Naoto8734/gripper-robo-BluePill/README.md

# gripper-robo-BluePill
STM32F103(BluePill)用の、CubeIDEのワークスペース。
回路図は以下の通り。(**未修正なので、現物と異なる**)

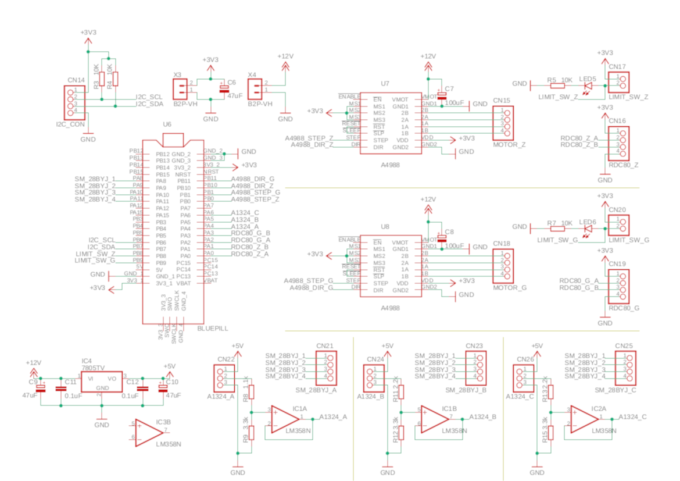
[picture p1: gripper-robo-controller-board.png]
circuit-board


LED_R(回路図に未記入)は、ピンがHIGHで点灯。
BluePill組み込みのLEDとは逆なので注意。
SW_BとSW_Wは、プルアップするので常時HIGH。押したときだけLOW。
マイコンのピン配置は次の通り。

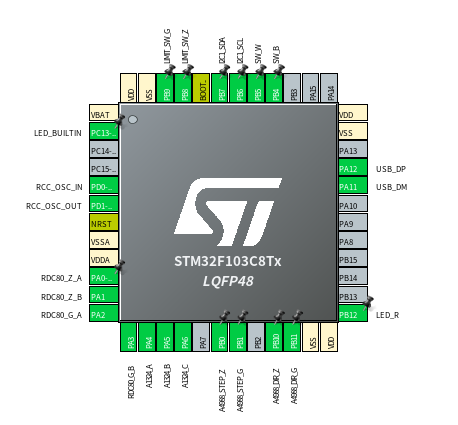
[picture p2: gripper-robo-pinmap.png]
pinmap


### グリッパーロボ用のリポジトリ一覧

- [ロボのグリッパー部のリポジトリ(これ)](https://github.com/Naoto8734/gripper-robo-BluePill)
- [ロボのXY直動部のリポジトリ](https://github.com/Naoto8734/xy-axis-robo-BluePill)
- [ロボの指先部のリポジトリ](https://github.com/Naoto8734/fingertip-robo-BluePill)

## 書き込み方法
OSはUbuntu。[J-Link EDU](https://www.embitek.co.jp/product/jlink-edu.html)を使用し、STM32CubeIDEで生成したbinファイルを書き込み。
**BluePill側の電源(3.3v)を入れておくこと。**
参考：[J-LinkでコマンドラインからマイコンのFlashに書き込む](http://idken.net/posts/2019-07-14-jlinkflash/)

### BluePillとJ-Link EDUとのピン接続

| SWD(JLink) | Pin# | | BluePill |
| ---- | ---- | ---- | ---- |
| VTref | 1 | |3V3(SWD-Connector) |
| GND | 4 | | GND(SWD-Connector) |
| SWDIO | 7 | | DIO(SWD-Connector) |
| SWCLK | 9 | | DCLK(SWD-Connector) |
| RESET | 15 | | R |

## ステッピングモータドライバA4988
- [ステッピングモータードライバA4988 - スイッチサイエンス](https://www.switch-science.com/catalog/582/)
 - 回路で、MS1,MS2,MS3はHIGHに固定しているので、1/16ステップ駆動
- 駆動するモータ：[Nema 17 Bipolar 59Ncm (84oz.in) 2A 42x48mm 4 Wires w/ 1m Cable & Connector](https://www.omc-stepperonline.com/nema-17-bipolar-59ncm-84oz-in-2a-42x48mm-4-wires-w-1m-cable-and-connector.html)
 - ステップアングルは、1.8[deg] = 360/200[deg]。
- よって、200*16=3200パルスをA4988に送るとステッピングモータは1回転。
- Z軸は1/2減速した後、ピッチ2mmの台形ネジによって移動する。
 - [304 ステンレス鋼 T12 台形スピンドルネジとナット - AliExpress](https://ja.aliexpress.com/item/32904305986.html)
 - つまり、ステッピングモータ1回転で1mm進む。
- グリッパは関節に1/20減速している。
 - つまり、関節角度は1/20すれば算出できる。
 
## 無限回転ポテンショメータRDC80
- [RDC80シリーズ｜RDC803101A｜基本情報](https://tech.alpsalpine.com/prod/j/html/sensor/position/rdc80/rdc803101a.html)
- 2T出力と4T出力が180度位相のずれたポテンショメータ。
- 基準勾配は100[%]/340[deg]なので、12[bit]でAD変換した時、角度分解能は340/4096=~0.083[deg]
- この基準勾配のうち、上限と下限の約3[%]/5[deg]は使用禁止領域。
 - よって使用可能範囲は、5[deg]~335[deg]。12[bit]の場合、60~4036。

## I2C Slave
- Slaveのアドレスを、`0x18`とする。(最終bitはR/Wなので、`0x0C`が7bitのアドレス)
- レジスタアドレス：`0x75` (WHO_AM_I)
 - 自身のSlaveアドレス`0x18`を返す
 
## C++に対応させる方法
参考：[How to Use C++ with STM32CubeIDE - Shawn Hymel](https://shawnhymel.com/1941/how-to-use-c-with-stm32cubeide/)

1. `main.c`を`main.cpp`に名前を変更。
2. `Project Explorer`の画面で、該当のプロジェクトを右クリック。`Convert C++`を選択。
3. Build (これで終了。HALの関数の引数がいくつか変更されるので、Errorに注意。)

### CubeMXで設定を変更した場合の対処法
`main.cpp`に変更しても、CubeMXで生成されるのは`main.c`のままとなる。
そこで、`main.cpp`を`main.c`に改名し、CubeMXからコードを生成する。
これにより、UserCodeの部分がそのまま引き継がれるので、再度`main.cpp`に変更し直す。
面倒くさい。

### 自作クラスの追加方法
1. `Project Explorer`の画面で、該当のプロジェクトを右クリック。`New -> (C++) Class`を選択。
2. Class Name`の欄に、適当な名前を入力して、Finish。
3. Coreフォルダに`***.h`と`***.cpp`ができるので、それぞれIncとSrcフォルダに突っ込む。
4. 作られた`***.h`ファイルで`#include "main.h"`する。
5. `main.cpp`ファイルで`#include "DriveMotor.h"`する。

クラスなどの命名規則：[ja/CppStyleGuide - ROS Wiki](http://wiki.ros.org/ja/CppStyleGuide)
