Naoto8734/gripper-robo-BluePill/Core/Src/main.c

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
/* Includes ------------------------------------------------------------------*/
#include "main.h"
#include "usb_device.h"

/* USER CODE BEGIN PTD */
typedef struct __potentio_rdc80 {
	double degree;
	int32_t half_rotation; //正方向に180degごとに1加算。
	double initial_degree;
	uint16_t phase_a;
	uint16_t phase_b;
} potentio_rdc80;

/* USER CODE END PTD */

/* USER CODE BEGIN PD */
//セッティング用定数
//グリッパーの目標角度[deg]
#define TARGET_GRIPPER_DEG 30.0
//z軸の目標下げ変位[mm]
#define TARGET_Z_DISP 86.0


//ADC
#define ADC_ARR_SIZE 7
#define ADC_12BIT_MAX 4095
//RDC80
#define ADC_RDC80_DEG_CONST 0.0830 //12bitのADC値から、角度に変換するための定数。
#define ADC_RDC80_MIN 1023-10 //この値未満になった時に、計測する相を切り替える。
#define ADC_RDC80_MAX 3071+10 //この値より上になった時に、計測する相を切り替える。
#define ADC_INIT_VAL_RDC80_ZA 3492
#define ADC_INIT_VAL_RDC80_ZB 1329 //こちらが最初に計測する相
#define ADC_INIT_DEG_Z -29.84131 +180.0 //初期角度(ADの実測値からの計算)
#define ADC_INIT_VAL_RDC80_GA 164
#define ADC_INIT_VAL_RDC80_GB 2152 //こちらが最初に計測する相
#define ADC_INIT_DEG_G 8.63281 - 180.0//初期角度(ADの実測値からの計算)
//(本当は-172degだが、phaseの初期値を-1するためこの角度)
/* USER CODE END PD */

ADC_HandleTypeDef hadc1;
DMA_HandleTypeDef hdma_adc1;

I2C_HandleTypeDef hi2c1;

TIM_HandleTypeDef htim3;

/* USER CODE BEGIN PV */
__IO uint16_t adc_vals[ADC_ARR_SIZE];
potentio_rdc80 prdZ, prdG;
/* USER CODE END PV */

void SystemClock_Config(void);
static void MX_GPIO_Init(void);
static void MX_DMA_Init(void);
static void MX_ADC1_Init(void);
static void MX_I2C1_Init(void);
static void MX_TIM3_Init(void);
/* USER CODE BEGIN PFP */
//void adc2deg_rdc80(potentio_rdc80 *);
void adc2deg_rdc80Z(void);
void driveZ(double);
void adc2deg_rdc80G(void);
void driveG(double);
/* USER CODE END PFP */

/**
  * @brief  The application entry point.
  * @retval int
  */
int main(void)
{
  /* MCU Configuration--------------------------------------------------------*/

  /* Reset of all peripherals, Initializes the Flash interface and the Systick. */
  HAL_Init();

  /* Configure the system clock */
  SystemClock_Config();

  /* Initialize all configured peripherals */
  MX_GPIO_Init();
  MX_DMA_Init();
  MX_ADC1_Init();
  MX_I2C1_Init();
  MX_TIM3_Init();
  MX_USB_DEVICE_Init();
  /* USER CODE BEGIN 2 */
	//タイマー割り込みの開始
	HAL_TIM_Base_Start_IT(&htim3);

	// Potentio RDc80 initialize
	prdZ.initial_degree = ADC_INIT_DEG_Z;
	prdZ.half_rotation = 1;//ADC_INIT_DEGの値により変える。
	prdG.initial_degree = ADC_INIT_DEG_G;
	prdG.half_rotation = -1;

	//ADCのDMA転送開始
	HAL_ADC_Start_DMA(&hadc1,(uint32_t *)adc_vals, ADC_ARR_SIZE);


  /* USER CODE END 2 */

  /* Infinite loop */
  /* USER CODE BEGIN WHILE */

	//Initialize A4988 pin
	//正の方向 : deg+ : グリッパ閉じる。
	HAL_GPIO_WritePin(A4988_DIR_G_GPIO_Port, A4988_DIR_G_Pin, GPIO_PIN_RESET);
	//正の方向 : deg+ : 下に下がる。
	HAL_GPIO_WritePin(A4988_DIR_Z_GPIO_Port, A4988_DIR_Z_Pin, GPIO_PIN_RESET);

	//Enable Motor PWM
	HAL_TIM_PWM_Start(&htim3, TIM_CHANNEL_3);
	HAL_TIM_PWM_Start(&htim3, TIM_CHANNEL_4);

	HAL_GPIO_WritePin(LED_R_GPIO_Port, LED_R_Pin, GPIO_PIN_SET);

	while (1) {
		//ボタン入力待機
		while(HAL_GPIO_ReadPin(SW_B_GPIO_Port, SW_B_Pin) != GPIO_PIN_RESET){
			HAL_GPIO_TogglePin(LED_R_GPIO_Port, LED_R_Pin);
			HAL_Delay(200);
		}
		HAL_GPIO_WritePin(LED_R_GPIO_Port, LED_R_Pin, GPIO_PIN_RESET);

		//Z軸下げる
		HAL_GPIO_WritePin(LED_BUILTIN_GPIO_Port, LED_BUILTIN_Pin, GPIO_PIN_RESET);
		driveZ(360.0*TARGET_Z_DISP);
		HAL_GPIO_WritePin(LED_BUILTIN_GPIO_Port, LED_BUILTIN_Pin, GPIO_PIN_SET);

		//ボタン入力待機
		while(HAL_GPIO_ReadPin(SW_B_GPIO_Port, SW_B_Pin) != GPIO_PIN_RESET){
			HAL_GPIO_TogglePin(LED_R_GPIO_Port, LED_R_Pin);
			HAL_Delay(200);
		}
		HAL_GPIO_WritePin(LED_R_GPIO_Port, LED_R_Pin, GPIO_PIN_RESET);

		//G軸閉じる
		HAL_GPIO_WritePin(LED_BUILTIN_GPIO_Port, LED_BUILTIN_Pin, GPIO_PIN_RESET);
		driveG(TARGET_GRIPPER_DEG*20.0);
		HAL_GPIO_WritePin(LED_BUILTIN_GPIO_Port, LED_BUILTIN_Pin, GPIO_PIN_SET);
		HAL_Delay(2000);

		//ボタン入力待機
		while(HAL_GPIO_ReadPin(SW_B_GPIO_Port, SW_B_Pin) != GPIO_PIN_RESET){
			HAL_GPIO_TogglePin(LED_R_GPIO_Port, LED_R_Pin);
			HAL_Delay(200);
		}
		HAL_GPIO_WritePin(LED_R_GPIO_Port, LED_R_Pin, GPIO_PIN_RESET);

		//Z軸戻す
		HAL_GPIO_WritePin(LED_BUILTIN_GPIO_Port, LED_BUILTIN_Pin, GPIO_PIN_RESET);
		driveZ(0.0);
		HAL_GPIO_WritePin(LED_BUILTIN_GPIO_Port, LED_BUILTIN_Pin, GPIO_PIN_SET);
		HAL_Delay(2000);

		//ボタン入力待機
		while(HAL_GPIO_ReadPin(SW_B_GPIO_Port, SW_B_Pin) != GPIO_PIN_RESET){
			HAL_GPIO_TogglePin(LED_R_GPIO_Port, LED_R_Pin);
			HAL_Delay(200);
		}
		HAL_GPIO_WritePin(LED_R_GPIO_Port, LED_R_Pin, GPIO_PIN_RESET);

		//G軸戻す
		HAL_GPIO_WritePin(LED_BUILTIN_GPIO_Port, LED_BUILTIN_Pin, GPIO_PIN_RESET);
		driveG(0.0);
		HAL_GPIO_WritePin(LED_BUILTIN_GPIO_Port, LED_BUILTIN_Pin, GPIO_PIN_SET);
		HAL_Delay(2000);
    /* USER CODE END WHILE */

    /* USER CODE BEGIN 3 */
	}
  /* USER CODE END 3 */
}

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
/* USER CODE BEGIN 4 */
void HAL_GPIO_EXTI_Callback(uint16_t GPIO_Pin) {
	//Todo:リミットスイッチ用の割り込み
	if (GPIO_Pin == LIMIT_SW_G_Pin) {
	}
	if (GPIO_Pin == LIMIT_SW_Z_Pin) {
	}
}

//下に下げると負の値になる。
void adc2deg_rdc80Z(void){
	if(((prdZ.half_rotation) %2) == 0){
		//a相が計測範囲内
		prdZ.degree = (double) ((prdZ.phase_a * ADC_RDC80_DEG_CONST) - 170.0);
		if(prdZ.phase_a < 683){
			//計測範囲を下回ったので、b相で計測する。
			prdZ.degree = (double) ((prdZ.phase_b * ADC_RDC80_DEG_CONST) - 170.0);
			prdZ.half_rotation--;
		}else if (prdZ.phase_a > 3413){
			//計測範囲を上回ったので、b相で計測する。
			prdZ.degree = (double) ((prdZ.phase_b * ADC_RDC80_DEG_CONST) - 170.0);
			prdZ.half_rotation++;
		}
	}else{
		//b相が計測範囲内
		prdZ.degree = (double) ((prdZ.phase_b * ADC_RDC80_DEG_CONST) - 170.0);
		if(prdZ.phase_b < 683){
			//計測範囲を下回ったので、a相で再計測する。
			prdZ.degree = (double) ((prdZ.phase_a * ADC_RDC80_DEG_CONST) - 170.0);
			prdZ.half_rotation--;
		}else if(prdZ.phase_b > 3413){
			//計測範囲を超えたので、a相で再計測する。
			prdZ.degree = (double) ((prdZ.phase_a * ADC_RDC80_DEG_CONST) - 170.0);
			prdZ.half_rotation++;
		}
	}
	prdZ.degree += (double) ((prdZ.half_rotation) * 180.0);
	prdZ.degree -= prdZ.initial_degree;
}

void adc2deg_rdc80G(void){
	if(((prdG.half_rotation) %2) == 0){
		//a相が計測範囲内
		prdG.degree = (double) ((prdG.phase_a * ADC_RDC80_DEG_CONST) - 170.0);
		if(prdG.phase_a < 683){
			//計測範囲を下回ったので、b相で計測する。
			prdG.degree = (double) ((prdG.phase_b * ADC_RDC80_DEG_CONST) - 170.0);
			prdG.half_rotation--;
		}else if (prdG.phase_a > 3413){
			//計測範囲を上回ったので、b相で計測する。
			prdG.degree = (double) ((prdG.phase_b * ADC_RDC80_DEG_CONST) - 170.0);
			prdG.half_rotation++;
		}
	}else{
		//b相が計測範囲内
		prdG.degree = (double) ((prdG.phase_b * ADC_RDC80_DEG_CONST) - 170.0);
		if(prdG.phase_b < 683){
			//計測範囲を下回ったので、a相で再計測する。
			prdG.degree = (double) ((prdG.phase_a * ADC_RDC80_DEG_CONST) - 170.0);
			prdG.half_rotation--;
		}else if(prdG.phase_b > 3413){
			//計測範囲を超えたので、a相で再計測する。
			prdG.degree = (double) ((prdG.phase_a * ADC_RDC80_DEG_CONST) - 170.0);
			prdG.half_rotation++;
		}
	}
	prdG.degree += (double) ((prdG.half_rotation) * 180.0);
	prdG.degree -= prdG.initial_degree;
}

void HAL_ADC_ConvCpltCallback(ADC_HandleTypeDef *hadc) {
	prdZ.phase_a = adc_vals[0];
	prdZ.phase_b = adc_vals[1];
	prdG.phase_a = adc_vals[2];
	prdG.phase_b = adc_vals[3];
}

//Z軸モータを指定の角度に駆動する関数。
//プラスを指定すると、下に動く。
void driveZ(double command_deg){
	uint8_t degOK = 0;
	double tmpDeg = 0.0;
	while (!degOK){
		adc2deg_rdc80Z();
		tmpDeg = command_deg + prdZ.degree;
		//adc2deg_rdc80Zは下方向へ動かすとマイナス。しかし、入力は下をプラスにしたいのでこうした。
		if(tmpDeg>=3.0){
			if(tmpDeg>=120.0)__HAL_TIM_SET_PRESCALER(&htim3,72-1);//Change motor speed
			else __HAL_TIM_SET_PRESCALER(&htim3,1152-1);//Change motor speed
			HAL_GPIO_WritePin(A4988_DIR_Z_GPIO_Port, A4988_DIR_Z_Pin, GPIO_PIN_RESET);
			__HAL_TIM_SET_COMPARE(&htim3, TIM_CHANNEL_3, 50);//Motor Z
		}else if (tmpDeg<= -3.0){
			if(tmpDeg<=-120.0)__HAL_TIM_SET_PRESCALER(&htim3,72-1);//Change motor speed
			else __HAL_TIM_SET_PRESCALER(&htim3,1152-1);//Change motor speed
			HAL_GPIO_WritePin(A4988_DIR_Z_GPIO_Port, A4988_DIR_Z_Pin, GPIO_PIN_SET);
			__HAL_TIM_SET_COMPARE(&htim3, TIM_CHANNEL_3, 50);//Motor Z
		}else {
			HAL_GPIO_WritePin(A4988_DIR_Z_GPIO_Port, A4988_DIR_Z_Pin, GPIO_PIN_RESET);
			__HAL_TIM_SET_COMPARE(&htim3, TIM_CHANNEL_3, 0);//Motor Z
			degOK = 1;
		}
		HAL_Delay(1);
	}
}

//プラスを指定すると閉じる。
void driveG(double command_deg){
	uint8_t degOK = 0;
	double tmpDeg = 0.0;
	while (!degOK){
		adc2deg_rdc80G();
		tmpDeg = command_deg - prdG.degree;
		if(tmpDeg>=5.0){
			if(tmpDeg>=120.0)__HAL_TIM_SET_PRESCALER(&htim3,72-1);//Change motor speed
			else __HAL_TIM_SET_PRESCALER(&htim3,1152-1);//Change motor speed
			HAL_GPIO_WritePin(A4988_DIR_G_GPIO_Port, A4988_DIR_G_Pin, GPIO_PIN_RESET);
			__HAL_TIM_SET_COMPARE(&htim3, TIM_CHANNEL_4, 50);//Motor G
		}else if (tmpDeg<= -5.0){
			if(tmpDeg<=-120.0)__HAL_TIM_SET_PRESCALER(&htim3,72-1);//Change motor speed
			else __HAL_TIM_SET_PRESCALER(&htim3,1152-1);//Change motor speed
			HAL_GPIO_WritePin(A4988_DIR_G_GPIO_Port, A4988_DIR_G_Pin, GPIO_PIN_SET);
			__HAL_TIM_SET_COMPARE(&htim3, TIM_CHANNEL_4, 50);//Motor G
		}else {
			HAL_GPIO_WritePin(A4988_DIR_G_GPIO_Port, A4988_DIR_G_Pin, GPIO_PIN_RESET);
			__HAL_TIM_SET_COMPARE(&htim3, TIM_CHANNEL_4, 0);//Motor G
			degOK = 1;
		}
		HAL_Delay(1);
	}
}

/* USER CODE END 4 */
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
