Naoto8734/gripper-robo-BluePill/gripper-robo-BluePill.ioc

Mcu.UserName=STM32F103C8Tx
PA0-WKUP.GPIO_Label=RDC80_Z_A
PA0-WKUP.Signal=ADCx_IN0
PA1.GPIO_Label=RDC80_Z_B
PA1.Signal=ADCx_IN1
PA11.Signal=USB_DM
PA12.Signal=USB_DP
PA2.GPIO_Label=RDC80_G_A
PA2.Signal=ADCx_IN2
PA3.GPIO_Label=RDC80_G_B
PA3.Signal=ADCx_IN3
PA4.GPIO_Label=A1324_A
PA4.Signal=ADCx_IN4
PA5.GPIO_Label=A1324_B
PA5.Signal=ADCx_IN5
PA6.GPIO_Label=A1324_C
PA6.Signal=ADCx_IN6
PB0.GPIO_Label=A4988_STEP_Z
PB0.Signal=S_TIM3_CH3
PB1.GPIO_Label=A4988_STEP_G
PB1.Signal=S_TIM3_CH4
PB10.GPIO_Label=A4988_DIR_Z
PB10.Signal=GPIO_Output
PB11.GPIO_Label=A4988_DIR_G
PB11.Signal=GPIO_Output
PB12.GPIO_Label=LED_R
PB12.Signal=GPIO_Output
PB4.GPIO_Label=SW_B
PB4.Signal=GPIO_Input
PB5.GPIO_Label=SW_W
PB5.Signal=GPIO_Input
PB6.Signal=I2C1_SCL
PB7.Signal=I2C1_SDA
PB8.GPIO_Label=LIMIT_SW_Z
PB8.Signal=GPXTI8
PB9.GPIO_Label=LIMIT_SW_G
PB9.Signal=GPXTI9
PC13-TAMPER-RTC.GPIO_Label=LED_BUILTIN
PC13-TAMPER-RTC.Signal=GPIO_Output
PD0-OSC_IN.Signal=RCC_OSC_IN
PD1-OSC_OUT.Signal=RCC_OSC_OUT
