Naoto8734/gripper-robo-BluePill/Core/Inc/main.h

#define LED_BUILTIN_Pin GPIO_PIN_13
#define LED_BUILTIN_GPIO_Port GPIOC
#define RDC80_Z_A_Pin GPIO_PIN_0
#define RDC80_Z_A_GPIO_Port GPIOA
#define RDC80_Z_B_Pin GPIO_PIN_1
#define RDC80_Z_B_GPIO_Port GPIOA
#define RDC80_G_A_Pin GPIO_PIN_2
#define RDC80_G_A_GPIO_Port GPIOA
#define RDC80_G_B_Pin GPIO_PIN_3
#define RDC80_G_B_GPIO_Port GPIOA
#define A1324_A_Pin GPIO_PIN_4
#define A1324_A_GPIO_Port GPIOA
#define A1324_B_Pin GPIO_PIN_5
#define A1324_B_GPIO_Port GPIOA
#define A1324_C_Pin GPIO_PIN_6
#define A1324_C_GPIO_Port GPIOA
#define A4988_STEP_Z_Pin GPIO_PIN_0
#define A4988_STEP_Z_GPIO_Port GPIOB
#define A4988_STEP_G_Pin GPIO_PIN_1
#define A4988_STEP_G_GPIO_Port GPIOB
#define A4988_DIR_Z_Pin GPIO_PIN_10
#define A4988_DIR_Z_GPIO_Port GPIOB
#define A4988_DIR_G_Pin GPIO_PIN_11
#define A4988_DIR_G_GPIO_Port GPIOB
#define LED_R_Pin GPIO_PIN_12
#define LED_R_GPIO_Port GPIOB
#define SW_B_Pin GPIO_PIN_4
#define SW_B_GPIO_Port GPIOB
#define SW_W_Pin GPIO_PIN_5
#define SW_W_GPIO_Port GPIOB
#define LIMIT_SW_Z_Pin GPIO_PIN_8
#define LIMIT_SW_Z_GPIO_Port GPIOB
#define LIMIT_SW_Z_EXTI_IRQn EXTI9_5_IRQn
#define LIMIT_SW_G_Pin GPIO_PIN_9
#define LIMIT_SW_G_GPIO_Port GPIOB
#define LIMIT_SW_G_EXTI_IRQn EXTI9_5_IRQn
