Naoto8734/gripper-robo-BluePill/(commit log)

2020-10-03 Add circuit png
2021-01-17 Remove 28byj-48 stepping motor circuit
2021-01-17 test of limit switch
2021-01-17 test of driving motors
2021-01-27 test for motor pwm generated timer3.
2021-01-27 Simple I2C test
2021-01-27 simple 1ch adc combert using I2C
2021-01-28 simple adc test using usb
2021-01-29 driving Z motor test
2021-01-29 Added two switches and one LED to the circuit.
2021-01-31 test of hall sensor (using LPF)
